NibblesLab/mz40kmidi/(commit log)

2020-04-19 README.mdに説明文を記述
2021-01-10 おまけスケッチを追加
2021-01-10 mz40kKeypadの説明を追加
